Jafar-ting91/Spot-Welder-mit-Lcd-dispaly-/(list of files, drawings)

Other design files:
Meister-Spot Welder 1.0/Meister-Spot Welder 1.0 c.dsn
Meister-Spot Welder 1.0/Meister-Spot Welder 1.0 f.dsn
