Jafar-ting91/Spot-Welder-mit-Lcd-dispaly-/Meister-Spot Welder 1.0/Meister-Spot Welder 1.0.kicad_pcb

## KiCad design Meister-Spot Welder 1.0/Meister-Spot Welder 1.0.kicad_pcb (2026-04-04, last stored version)

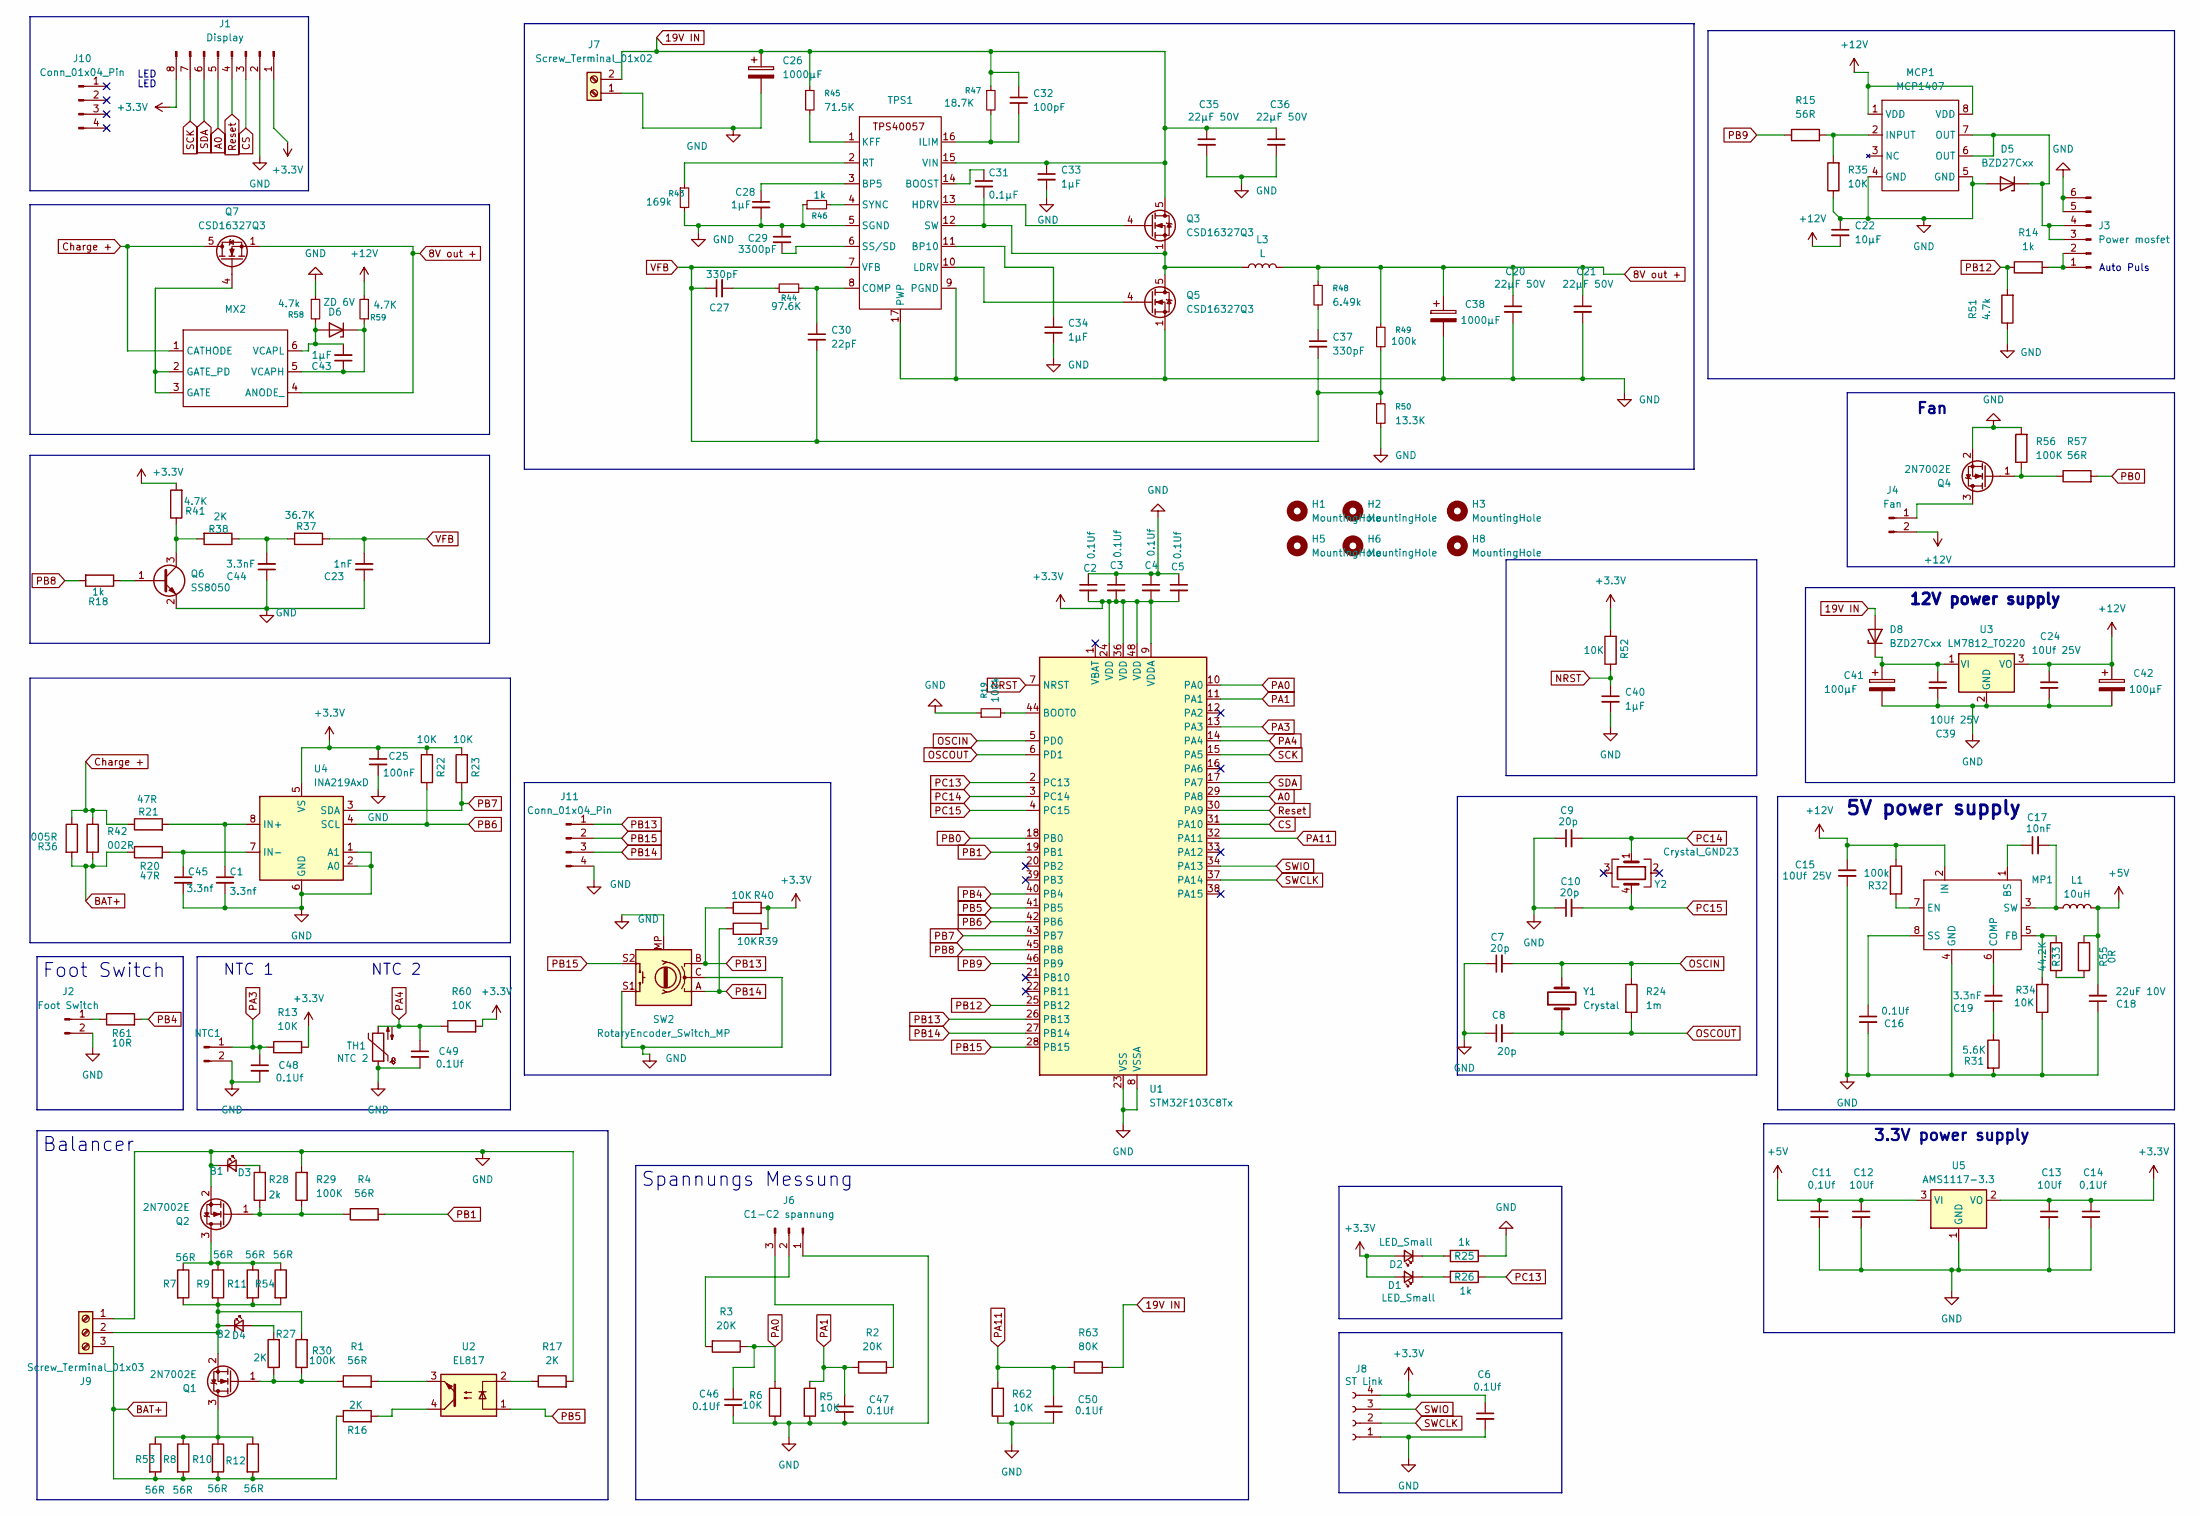
[picture p6: schematic Meister-Spot Welder 1.0.kicad_sch]

Parts:
C1, C45: 3.3nf; C_0603_1608Metric_Pad1.08x0.95mm_HandSolder
C2, C3, C4, C5, C6, C16, C46, C47, C48, C49, C50: 0.1Uf; C_0603_1608Metric_Pad1.08x0.95mm_HandSolder
C7, C8, C9, C10: 20p; C_0603_1608Metric_Pad1.08x0.95mm_HandSolder
C11, C14: 0,1Uf; C_0603_1608Metric_Pad1.08x0.95mm_HandSolder
C12, C13: 10Uf; C_0805_2012Metric
C15, C24, C39: 10Uf 25V; C_1206_3216Metric_Pad1.33x1.80mm_HandSolder
C17: 10nF; C_0603_1608Metric_Pad1.08x0.95mm_HandSolder
C18: 22uF 10V; C_1206_3216Metric_Pad1.33x1.80mm_HandSolder
C19, C44: 3.3nF; C_0603_1608Metric_Pad1.08x0.95mm_HandSolder
C20, C21, C35, C36: 22µF 50V; C_1206_3216Metric_Pad1.33x1.80mm_HandSolder
C22: 10µF; C_0805_2012Metric
C23: 1nF; C_0603_1608Metric_Pad1.08x0.95mm_HandSolder
C25: 100nF; C_0603_1608Metric_Pad1.08x0.95mm_HandSolder
C26, C38: 1000µF; CP_Radial_D10.0mm_P5.00mm
C27, C37: 330pF; C_0603_1608Metric_Pad1.08x0.95mm_HandSolder
C28, C33, C34, C40, C43: 1µF; C_0603_1608Metric_Pad1.08x0.95mm_HandSolder
C29: 3300pF; C_0603_1608Metric_Pad1.08x0.95mm_HandSolder
C30: 22pF; C_0603_1608Metric_Pad1.08x0.95mm_HandSolder
C31: 0.1µF; C_0603_1608Metric_Pad1.08x0.95mm_HandSolder
C32: 100pF; C_0603_1608Metric_Pad1.08x0.95mm_HandSolder
C41, C42: 100µF; CP_Elec_6.3x5.9
D1, D2: LED_Small; LED_0603_1608Metric_Pad1.05x0.95mm_HandSolder
D3: B1; LED_0603_1608Metric_Pad1.05x0.95mm_HandSolder
D4: B2; LED_0603_1608Metric_Pad1.05x0.95mm_HandSolder
D5: BZD27Cxx; D_SMF
D6: ZD 6V; D_SMF
D8: BZD27Cxx; D_SOD-128
H1, H2, H3, H5, H6, H8: MountingHole; MountingHole_3.2mm_M3
J1: Display; PinHeader_1x08_P2.54mm_Vertical
J2: Foot Switch; JST_EH_B2B-EH-A_1x02_P2.50mm_Vertical
J3: Power mosfet; PinHeader_1x06_P2.54mm_Vertical
J4: Fan; JST_EH_B2B-EH-A_1x02_P2.50mm_Vertical
J5: NTC1; JST_EH_B2B-EH-A_1x02_P2.50mm_Vertical
J6: C1-C2 spannung; JST_EH_B3B-EH-A_1x03_P2.50mm_Vertical
J7: Screw_Terminal_01x02; PhoenixContact_MCV_1,5_2-G-5.08_1x02_P5.08mm_Vertical
J8: ST Link; PinHeader_1x04_P2.54mm_Vertical
J9: Screw_Terminal_01x03; PhoenixContact_MCV_1,5_3-G-5.08_1x03_P5.08mm_Vertical
J10, J11: Conn_01x04_Pin; PinHeader_1x04_P2.54mm_Vertical
L1: 10uH; L_7.3x7.3_H3.5
L3: L; L_Toroid_Vertical_L17.8mm_W9.7mm_P7.11mm_Pulse_B
MCP1: MCP1407; SOIC-8_3.9x4.9mm_P1.27mm
MP1: SO-8_3.9x4.9mm_P1.27mm
MX2: SOT-23-6
Q1, Q2, Q4: 2N7002E; SOT-23-3
Q3, Q5, Q7: CSD16327Q3; PowerPAK_SO-8_Single
Q6: SS8050; SOT-23
R1, R4, R15, R57: 56R; R_0603_1608Metric_Pad0.98x0.95mm_HandSolder
R2, R3: 20K; R_0603_1608Metric_Pad0.98x0.95mm_HandSolder
R5, R6, R13, R22, R23, R34, R35, R39, R40, R52, R60, R62: 10K; R_0603_1608Metric_Pad0.98x0.95mm_HandSolder
R7, R8, R9, R10, R11, R12, R53, R54: 56R; R_2010_5025Metric_Pad1.40x2.65mm_HandSolder
R14, R18, R25, R26, R46: 1k; R_0603_1608Metric_Pad0.98x0.95mm_HandSolder
R16, R17, R27, R38: 2K; R_0603_1608Metric_Pad0.98x0.95mm_HandSolder
R19, R32, R49: 100k; R_0603_1608Metric_Pad0.98x0.95mm_HandSolder
R20, R21: 47R; R_0603_1608Metric_Pad0.98x0.95mm_HandSolder
R24: 1m; R_0603_1608Metric_Pad0.98x0.95mm_HandSolder
R28: 2k; R_0603_1608Metric_Pad0.98x0.95mm_HandSolder
R29, R30, R56: 100K; R_0603_1608Metric_Pad0.98x0.95mm_HandSolder
R31: 5.6K; R_0603_1608Metric_Pad0.98x0.95mm_HandSolder
R33: 44.2K; R_0603_1608Metric_Pad0.98x0.95mm_HandSolder
R36: 005R; R_2512_6332Metric
R37: 36.7K; R_0603_1608Metric_Pad0.98x0.95mm_HandSolder
R41, R59: 4.7K; R_0603_1608Metric_Pad0.98x0.95mm_HandSolder
R42: 002R; R_2512_6332Metric
R43: 169k; R_0603_1608Metric_Pad0.98x0.95mm_HandSolder
R44: 97.6K; R_0603_1608Metric_Pad0.98x0.95mm_HandSolder
R45: 71.5K; R_0603_1608Metric_Pad0.98x0.95mm_HandSolder
R47: 18.7K; R_0603_1608Metric_Pad0.98x0.95mm_HandSolder
R48: 6.49k; R_0603_1608Metric_Pad0.98x0.95mm_HandSolder
R50: 13.3K; R_0603_1608Metric_Pad0.98x0.95mm_HandSolder
R51, R58: 4.7k; R_0603_1608Metric_Pad0.98x0.95mm_HandSolder
R55: 0R; R_0603_1608Metric_Pad0.98x0.95mm_HandSolder
R61: 10R; R_0603_1608Metric_Pad0.98x0.95mm_HandSolder
R63: 80K; R_0603_1608Metric_Pad0.98x0.95mm_HandSolder
SW2: RotaryEncoder_Switch_MP; RotaryEncoder_Alps_EC11E-Switch_Vertical_H20mm
TH1: NTC 2; R_0603_1608Metric
TPS1: HTSSOP-16-1EP_4.4x5mm_P0.65mm_EP3x3mm
U1: STM32F103C8Tx; LQFP-48_7x7mm_P0.5mm
U2: EL817; DIP-4_W7.62mm
U3: LM7812_TO220; TO-252-2
U4: INA219AxD; SOIC-8_3.9x4.9mm_P1.27mm
U5: AMS1117-3.3; SOT-223-3_TabPin2
Y1: Crystal; Crystal_HC49-4H_Vertical
Y2: Crystal_GND23; Crystal_SMD_SeikoEpson_MC306-4Pin_8.0x3.2mm

Connections:
8V out +: C20.1, C21.1, C38.1, L3.2, MX2.4 (ANODE_), Q7.1 (S), Q7.2 (S), Q7.3 (S), R48.1, R49.1
19V IN: C26.1, C32.1, C33.1, C35.1, C36.1, D8.2 (A), J7.2, Q3.5 (D), R45.1, R47.1, R63.1, TPS1.15 (VIN)
+3.3V: C2.2, C3.2, C4.2, C5.2, C6.1, C13.1, C14.1, C25.1, D1.2 (A), D2.2 (A), J1.1, J1.8, J8.4, R13.2, R22.2, R23.2, R39.2, R40.2, R41.2, R52.2, R60.2, U1.9 (VDDA), U1.24 (VDD), U1.36 (VDD), U1.48 (VDD), U4.5 (VS), U5.2 (VO)
+5V: C11.1, C12.1, C18.2, L1.2, R55.1, U5.3 (VI)
+12V: C15.1, C22.2, C24.1, C42.1, J4.2, MCP1.1 (VDD), MCP1.8 (VDD), MP1.2 (IN), R32.1, R59.2, U3.3 (VO)
A0: J1.5, U1.29 (PA8)
BAT+: J9.3, R8.2, R10.2, R12.2, R16.1, R20.1, R36.2, R42.2, R53.2
CS: J1.3, U1.31 (PA10)
Charge +: MX2.1 (CATHODE), Q7.5 (D), R21.1, R36.1, R42.1
GND: C1.2, C2.1, C3.1, C4.1, C5.1, C6.2, C7.1, C8.1, C9.1, C10.1, C11.2, C12.2, C13.2, C14.2, C15.2, C16.2, C18.1, C20.2, C21.2, C22.1, C23.1, C24.2, C25.2, C26.2, C28.2, C29.1, C33.2, C34.2, C35.2, C36.2, C38.2, C39.2, C40.2, C41.2, C42.2, C44.1, C45.2, C46.2, C47.2, C48.2, C49.2, C50.2, D3.1 (K), D5.2 (A), J1.2, J2.2, J3.5, J3.6, J5.2, J6.1, J7.1, J8.1, J9.1, J11.4, MCP1.4 (GND), MCP1.5 (GND), MP1.4 (GND), Q2.2 (S), Q4.2 (S), Q5.1 (S), Q5.2 (S), Q5.3 (S), Q6.2 (E), R5.1, R6.1, R17.2, R19.1, R25.1, R29.2, R31.2, R34.1, R35.1, R43.2, R46.1, R50.2, R51.1, R56.2, R58.1, R62.1, SW2.C, SW2.MP, SW2.S1, TH1.1, TPS1.5 (SGND), TPS1.9 (PGND), TPS1.17 (PWP), U1.8 (VSSA), U1.23 (VSS), U1.35 (VSS), U1.47 (VSS), U3.2 (GND), U4.1 (A1), U4.2 (A0), U4.6 (GND), U5.1 (GND)
NRST: C40.1, R52.1, U1.7 (NRST)
unnamed: C19.1, R31.1
unnamed: C27.2, R44.1
unnamed: C37.1, R48.2
unnamed: C44.2, R37.2, R38.1
unnamed: D1.1 (K), R26.2
unnamed: D2.1 (K), R25.2
unnamed: D3.2 (A), R28.2
unnamed: D4.2 (A), R27.2
unnamed: D4.1 (K), J9.2, Q1.2 (S), R7.2, R9.2, R11.2, R30.2, R54.2
unnamed: D5.1 (K), J3.3, J3.4, MCP1.6 (OUT), MCP1.7 (OUT)
unnamed: C43.2, D6.2 (A), MX2.6 (VCAPL), R58.2
unnamed: C43.1, D6.1 (K), MX2.5 (VCAPH), R59.1
unnamed: C39.1, C41.1, D8.1 (K), U3.1 (VI)
unnamed: J2.1, R61.1
unnamed: J3.1, J3.2, R14.2
unnamed: J4.1, Q4.3 (D)
unnamed: J6.2, R3.2
unnamed: J6.3, R2.1
unnamed: MCP1.2 (INPUT), R15.2, R35.2
unnamed: C17.1, MP1.1 (BS)
unnamed: C19.2, MP1.6 (COMP)
unnamed: MP1.7 (EN), R32.2
unnamed: MP1.5 (FB), R33.1, R34.2
unnamed: C16.1, MP1.8 (SS)
unnamed: C17.2, L1.1, MP1.3 (SW)
unnamed: MX2.2 (GATE_PD), MX2.3 (GATE), Q7.4 (G)
unnamed: Q1.3 (D), R8.1, R10.1, R12.1, R53.1
unnamed: Q1.1 (G), R1.1, R27.1, R30.1
unnamed: Q2.3 (D), R7.1, R9.1, R11.1, R54.1
unnamed: Q2.1 (G), R4.1, R28.1, R29.1
unnamed: Q3.4 (G), TPS1.13 (HDRV)
unnamed: Q4.1 (G), R56.1, R57.1
unnamed: C31.2, L3.1, Q3.1 (S), Q3.2 (S), Q3.3 (S), Q5.5 (D), TPS1.12 (SW)
unnamed: Q5.4 (G), TPS1.10 (LDRV)
unnamed: Q6.1 (B), R18.1
unnamed: Q6.3 (C), R38.2, R41.1
unnamed: R1.2, U2.3
unnamed: R16.2, U2.4
unnamed: R17.1, U2.2
unnamed: R33.2, R55.2
unnamed: C31.1, TPS1.14 (BOOST)
unnamed: C28.1, TPS1.3 (BP5)
unnamed: C34.1, TPS1.11 (BP10)
unnamed: C30.1, R44.2, TPS1.8 (COMP)
unnamed: C32.2, R47.2, TPS1.16 (ILIM)
unnamed: R45.2, TPS1.1 (KFF)
unnamed: R43.1, TPS1.2 (RT)
unnamed: C29.2, TPS1.6 (SS/SD)
unnamed: R46.2, TPS1.4 (SYNC)
unnamed: R19.2, U1.44 (BOOT0)
unnamed: C1.1, R21.2, U4.8 (IN+)
unnamed: C45.1, R20.2, U4.7 (IN-)
OSCIN: C7.2, R24.1, U1.5 (PD0), Y1.2
OSCOUT: C8.2, R24.2, U1.6 (PD1), Y1.1
PA0: C46.1, R3.1, R6.2, U1.10 (PA0)
PA1: C47.1, R2.2, R5.2, U1.11 (PA1)
PA3: C48.1, J5.1, R13.1, U1.13 (PA3)
PA4: C49.1, R60.1, TH1.2, U1.14 (PA4)
PA11: C50.1, R62.2, R63.2, U1.32 (PA11)
PB0: R57.2, U1.18 (PB0)
PB1: R4.2, U1.19 (PB1)
PB4: R61.2, U1.40 (PB4)
PB5: U1.41 (PB5), U2.1
PB6: R22.1, U1.42 (PB6), U4.4 (SCL)
PB7: R23.1, U1.43 (PB7), U4.3 (SDA)
PB8: R18.2, U1.45 (PB8)
PB9: R15.1, U1.46 (PB9)
PB12: R14.1, R51.2, U1.25 (PB12)
PB13: J11.1, R40.1, SW2.B, U1.26 (PB13)
PB14: J11.3, R39.1, SW2.A, U1.27 (PB14)
PB15: J11.2, SW2.S2, U1.28 (PB15)
PC13: R26.1, U1.2 (PC13)
PC14: C9.2, U1.3 (PC14), Y2.1
PC15: C10.2, U1.4 (PC15), Y2.4
Reset: J1.4, U1.30 (PA9)
SCK: J1.7, U1.15 (PA5)
SDA: J1.6, U1.17 (PA7)
SWCLK: J8.2, U1.37 (PA14)
SWIO: J8.3, U1.34 (PA13)
VFB: C23.2, C27.1, C30.2, C37.2, R37.1, R49.2, R50.1, TPS1.7 (VFB)

Notes on the sheet:
3.3V power supply
LED
NTC 1
NTC 2
Auto Puls
12V power supply
5V power supply
Fan
Foot Switch
Balancer
Spannungs Messung

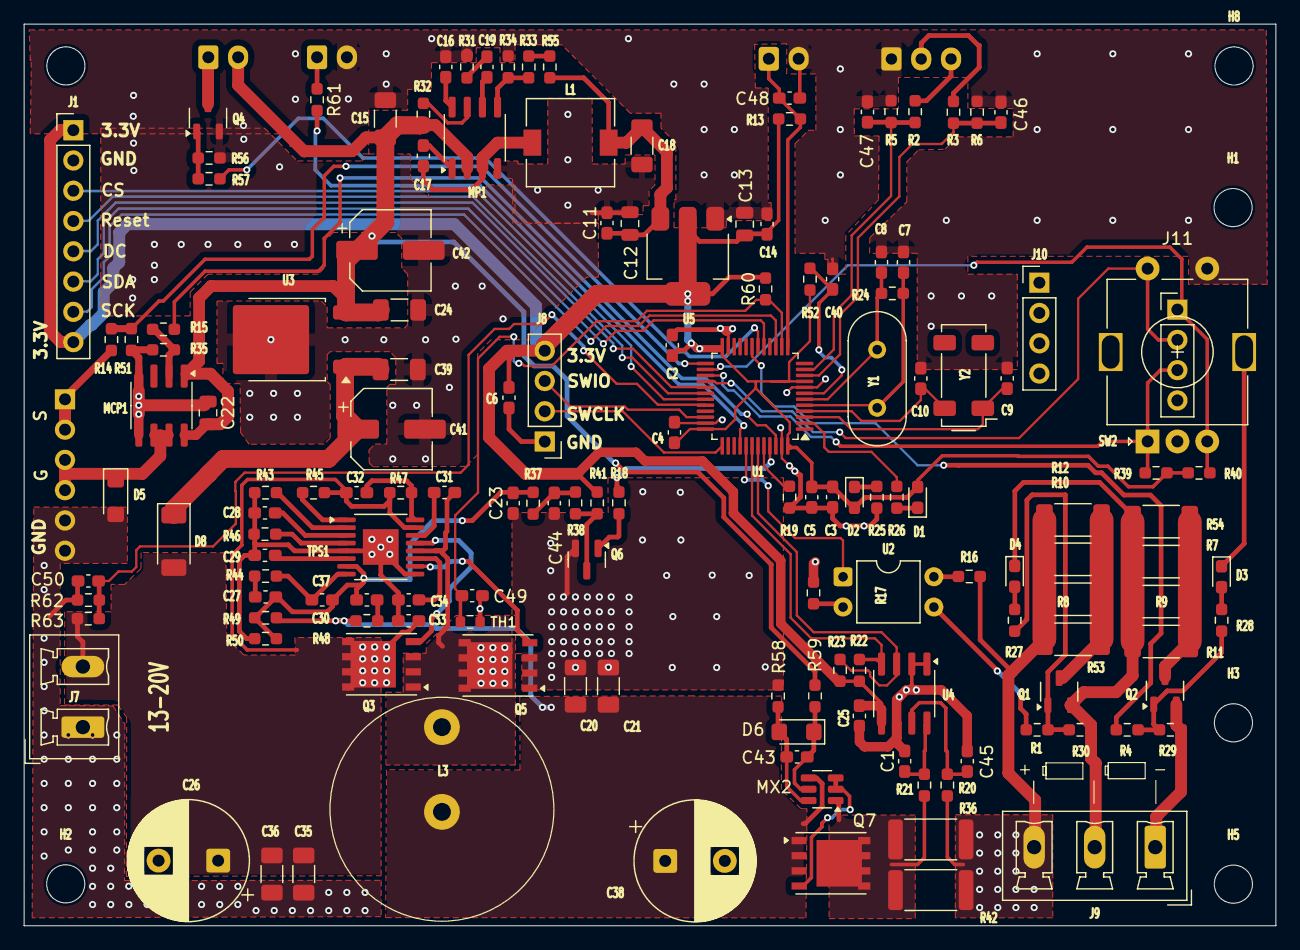
[picture p7: board Meister-Spot Welder 1.0.kicad_pcb from above]

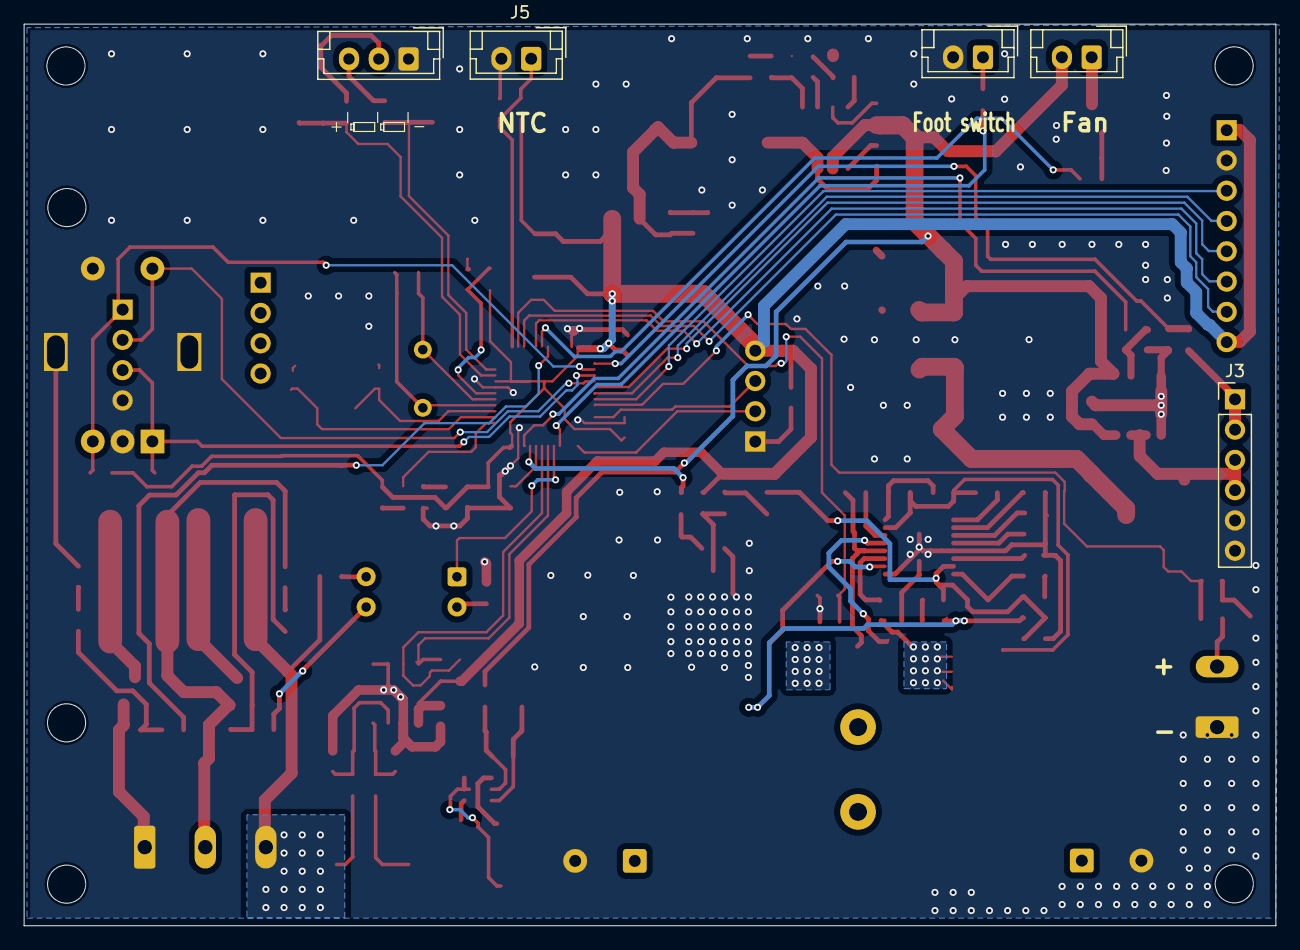
[picture p8: board Meister-Spot Welder 1.0.kicad_pcb from below]

Board: 2 copper layers, 105.0 x 75.6 mm, 159 parts (5 on the bottom side), 91 nets.
