Jafar-ting91/Spot-Welder-mit-Lcd-dispaly-/(commit log)

2026-04-04 Update README.md
    ⚠️ Projektstatus
    🟡 Aktiv in Entwicklung
    Die aktuelle Version ist voll funktionsfähig und wird im praktischen Einsatz verwendet.
    Alle Hauptfunktionen (Laden, Schweißen, Anzeige, Schutzmechanismen) laufen stabil.
    👉 Trotzdem gilt:
    Einige Bereiche sind noch in Optimierung
    UI und Regelverhalten werden weiter verbessert
    Code wird laufend aufgeräumt und erweitert
    Kurz gesagt:
    ✔ Funktioniert zuverlässig
    🔧 Wird kontinuierlich verbessert
    ⚡ Leistung & technische Daten
    Max. Ladeleistung: ~60 W
    Max. Ladestrom: ~10 A (geregelt)
    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
2026-10-18 Revise README for bilingual support and clarity
    Updated README to provide English descriptions and features for the STM32 capacitor spot welder project.
